jayvala5555/Robocon-2022/README.md

# Robocon-2022
This repositary contains documentation and codes related to Robocon 2022 project. Robocon is competition organized by ABU Robocon. The ABU Asia-Pacific Robot
Contest (ABU Robocon) is an Asian-Oceanian college robot competition. In the competition robots compete to complete a task within a set period of time. The game
was based on the game of lagori. 

[`Robocon 2022 Robots Videos`](https://drive.google.com/drive/folders/1I_im-UR2T1dI1tAkookunJnYWvszwKDN?usp=sharing)
