jayvala5555/Robocon-2022/Misclleneous Codes/Neno2/Neno2.ino

#include <Wire.h>
#include <EasyTransferI2C.h>

//create object
EasyTransferI2C ET; 

struct SEND_DATA_STRUCTURE{
  //put your variable definitions here for the data you want to send
  //THIS MUST BE EXACTLY THE SAME ON THE OTHER ARDUINO
  int16_t AccX;
  int16_t AccY;
  int16_t AccZ;
};

//give a name to the group of data
SEND_DATA_STRUCTURE mydata;

//define slave i2c address
#define I2C_SLAVE_ADDRESS 9

void setup(){
  Wire.begin();
  //start the library, pass in the data details and the name of the serial port. Can be Serial, Serial1, Serial2, etc.
  ET.begin(details(mydata), &Wire);

  
  randomSeed(analogRead(0));
  
}

void loop(){
  //this is how you access the variables. [name of the group].[variable name]
  mydata.AccX = 10;
  mydata.AccY = 11;
  mydata.AccZ = 12;
  //send the data
  ET.sendData(I2C_SLAVE_ADDRESS);
 
  delay(1000);
}
