jayvala5555/Robocon-2022/Final Code R2 Robot/PS3/Pneumatics.ino

void Pneumatic1UP()
{
    digitalWrite(Pneu1up,HIGH);

}
void Pneumatic1DOWN()
{
    digitalWrite(Pneu1down,HIGH);

}

void Pneumatic2UP()
{
    digitalWrite(Pneu2up,HIGH);
}

void Pneumatic2DOWN()
{

    digitalWrite(Pneu2down,HIGH);
    
}
