jayvala5555/Robocon-2022/Misclleneous Codes/ULN2003A/ULN2003A.ino

//  const int pin6 = 6;
//  const int pin7 = 7;
const int pin12 = 12;

void setup() {
  pinMode(pin12, OUTPUT);
//  pinMode(pin6, INPUT);
//  pinMode(pin7, INPUT);
}

void loop() {
      digitalWrite(pin12, HIGH);
  

}
